janolewandowski/Smart-home/Hardware/CLU.png

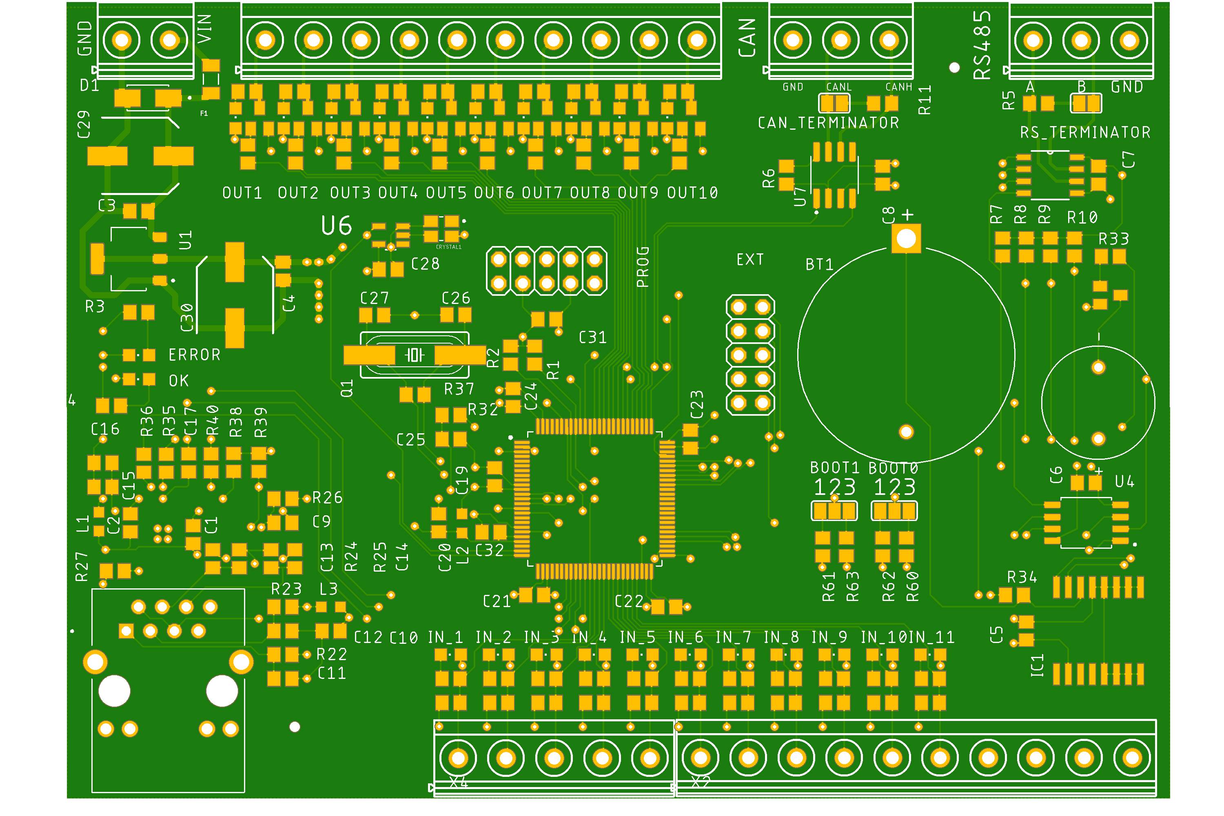
Hardware/CLU.png
