janolewandowski/Smart-home/Hardware/CLU.brd

## EAGLE design Hardware/CLU.brd (2024-02-14)

Schematic: CLU.sch

Parts:
BOOT0, BOOT1: SJ2W; SJ_2
BT1: VL-2320/HFN; BAT_VL-2320/HFN
C1, C2, C3, C4, C5, C6, C7, C8, C9, C11, C12, C13, C14, C17, C18, C19, C20, C21, C22, C23, C24, C25, C28, C31, C32: 100nF; C0805
C10: 0.022uF; C0805
C15: 470pF; C0805
C16: 1uF; C0805
C26, C27: 22pF; C0805
C29, C30: 100uF; SANYO-OSCON_SMD_E7
CAN_TERMINATOR: SJ
CRYSTAL1: LFSPXO025560; LFSPXO025560-SMD-4
D1: BYG10D; DIO_ES1J
ERROR: LEDCHIPLED_0805; CHIPLED_0805
EXT: PINHD-2X5; 2X05
F1: ERBRG1R25V; FUSC1206X75N
IC1: DS3231/SO; SO16W
IN_1, IN_2, IN_3, IN_4, IN_5, IN_6, IN_7, IN_8, IN_9, IN_10, IN_11: LEDCHIPLED_0805; CHIPLED_0805
J2: SI-60062-F; BEL_SI-60062-F
L1, L2, L3: L-USL2012C; L2012C
LS1: CEM-1205C; CUI_CEM-1205C
OK: LEDCHIPLED_0805; CHIPLED_0805
OUT1, OUT2, OUT3, OUT4, OUT5, OUT6, OUT7, OUT8, OUT9, OUT10: LEDCHIPLED_0805; CHIPLED_0805
PROG: PINHD-2X5; 2X05
Q1: CRYSTALHC49UP; HC49UP
R1, R2, R7, R8, R9, R10, R12, R13, R14, R15, R16, R17, R18, R19, R20, R21, R30, R31, R32, R33, R41, R42, R43, R44, R45, R46, R47, R48, R49, R60, R61, R62, R63: 10k; R0805
R3, R4: 330R; R0805
R5, R11: 120R; R0805
R6, R26: 4k7; R0805
R22, R23, R24, R25: 49R9; R0805
R27: 12.1k; R0805
R28, R29, R34, R50, R51, R52, R53, R54, R55, R56, R57, R58, R59, R64, R65, R66, R67, R68, R69, R70, R71, R72, R73, R74: 200R; R0805
R35, R36, R40, R75: 100R; R0805
R37: 1M; R0805
R38, R39: 1k5; R0805
RS_TERMINATOR: SJ
T1, T2, T3, T4, T5, T6, T7, T8, T9, T10, T11: BC848; SOT23
U1: AMS1117; SOT229P700X180-4N
U2: ST3485ECDR; SOIC127P600X175-8N
U3: STM32F107VCT6; QFP50P1600X1600X160-100N
U4: W25Q64BVSSIG; SOIC127P790X216-8N
U5: LAN8720A-CP; QFN50P400X400X100-25N
U6: 74LVC1G17W5-7; SOT95P280X145-5N
U7: SN65HVD230; SOIC127P599X175-8N
X1, X2: MKDSN1,5/10-5,08
X3: MKDSN1,5/2-5,08
X4: MKDSN1,5/5-5,08
X5, X6: MKDSN1,5/3-5,08

Connections:
12V: C3.1, C29.+, D1.K (CATHODE), F1.2, U1.3 (VIN)
BOOT0: BOOT0.2, U3.94 (BOOT0)
BUZZER: R33.1, U3.36 (PB1)
CAN_RX: U3.81 (PD0), U7.4 (R)
CAN_TX: U3.82 (PD1), U7.1 (D)
EHT_MDIO_LAN: R38.1, R75.2, U5.12 (MDIO)
ETH_CRS_DV: R40.1, U3.32 (PA7)
ETH_INT: R39.1, U3.15 (PC0), U5.14 (!NINT!/REFCLKO)
ETH_LED1: R28.1, U5.3 (LED1/REGOFF)
ETH_LED2: R29.1, U5.2 (LED2/!NINTSEL!)
ETH_MDC: U3.16 (PC1), U5.13 (MDC)
ETH_MDIO: R75.1, U3.25 (PA2)
ETH_RBIAS: R27.2, U5.24 (RBIAS)
ETH_RST: C9.1, R26.2, U5.15 (!NRST)
ETH_RXD0: R35.1, U3.33 (PC4)
ETH_RXD1: R36.1, U3.34 (PC5)
ETH_RX_N: C14.1, J2.6 (RD-), R25.2, U5.22 (RXN)
ETH_RX_P: C13.1, J2.4 (RD+), R24.2, U5.23 (RXP)
ETH_TXD0: U3.51 (PB12), U5.17 (TXD0)
ETH_TXD1: U3.52 (PB13), U5.18 (TXD1)
ETH_TX_EN: U3.48 (PB11), U5.16 (TXEN)
ETH_TX_N: C12.1, J2.3 (TD-), R23.2, U5.20 (TXN)
ETH_TX_P: C11.1, J2.1 (TD+), R22.2, U5.21 (TXP)
ETH_VDDA: C1.1, C2.1, J2.9 (YA), L1.2, L3.2, R22.1, R23.1, R24.1, R25.1, U5.1 (VDD2A), U5.19 (VDD1A)
ETH_VDDCR: C15.1, C16.1, U5.6 (VDDCR)
ETH_XTAL1: U3.24 (PA1), U5.5 (XTAL1/CLKLN), U6.4 (Y)
GND: BT1.N, C1.2, C2.2, C3.2, C4.2, C5.2, C6.2, C7.2, C8.2, C9.2, C10.2, C11.2, C12.2, C13.2, C14.2, C15.2, C16.2, C17.2, C18.2, C19.2, C20.2, C21.2, C22.2, C23.2, C24.2, C25.2, C26.1, C27.1, C28.2, C29.-, C30.-, C31.1, C32.2, CRYSTAL1.2 (GND), D1.A (ANODE), ERROR.C, EXT.7, IC1.5 (NC), IC1.6 (NC1), IC1.7 (NC2), IC1.8 (NC3), IC1.9 (NC4), IC1.10 (NC5), IC1.11 (NC6), IC1.12 (NC7), IC1.13 (GND), J2.8, J2.12 (GK), J2.S1 (SHIELD), J2.S2 (SHIELD), OK.C, PROG.4, R6.2, R27.1, R60.1, R61.1, T1.2 (E), T2.2 (E), T3.2 (E), T4.2 (E), T5.2 (E), T6.2 (E), T7.2 (E), T8.2 (E), T9.2 (E), T10.2 (E), T11.2 (E), U1.1 (ADJ/GND), U2.5 (GND), U3.10 (VSS), U3.19 (VSSA), U3.27 (VSS), U3.49 (VSS), U3.74 (VSS), U3.99 (VSS), U4.4 (GND), U5.25 (VSS), U6.3 (GND), U7.2 (GND), X2.7, X2.8, X3.1, X5.1, X6.3
I2C1_SCL: IC1.16 (SCL), R1.2, U3.92 (PB6), X2.10
I2C1_SDA: IC1.15 (SDA), R2.2, U3.93 (PB7), X2.9
IN_1: BOOT1.2, R44.2, R64.2, U3.37 (PB2), X4.1
IN_2: R30.2, R65.2, U3.38 (PE7), X4.2
IN_3: R31.2, R66.2, U3.39 (PE8), X4.3
IN_4: R43.2, R67.2, U3.40 (PE9), X4.4
IN_5: R41.2, R68.2, U3.41 (PE10), X4.5
IN_6: R45.2, R69.2, U3.42 (PE11), X2.1
IN_7: R42.2, R70.2, U3.43 (PE12), X2.2
IN_8: R46.2, R71.2, U3.44 (PE13), X2.3
IN_9: R48.2, R72.2, U3.45 (PE14), X2.4
IN_10: R47.2, R73.2, U3.46 (PE15), X2.5
IN_11: R49.2, R74.2, U3.47 (PB10), X2.6
LED_ERROR: R3.1, U3.3 (PE4)
LED_OK: R4.1, U3.2 (PE3)
unnamed: CAN_TERMINATOR.1, U7.7 (CANH), X5.2
unnamed: R11.2, U7.6 (CANL), X5.3
unnamed: R5.1, U2.6 (A), X6.1
unnamed: RS_TERMINATOR.2, U2.7 (B), X6.2
unnamed: BT1.P, IC1.14 (VBAT), R34.2
unnamed: R17.2, T6.1 (B)
unnamed: R18.2, T7.1 (B)
unnamed: R19.2, T8.1 (B)
unnamed: R20.2, T9.1 (B)
unnamed: OUT1.C, R50.1
unnamed: R21.2, T10.1 (B)
unnamed: R5.2, RS_TERMINATOR.1
unnamed: R6.1, U7.8 (RS)
unnamed: CAN_TERMINATOR.2, R11.1
unnamed: R12.2, T1.1 (B)
unnamed: R13.2, T2.1 (B)
unnamed: OK.A, R4.2
unnamed: ERROR.A, R3.2
unnamed: R14.2, T3.1 (B)
unnamed: R15.2, T4.1 (B)
unnamed: R16.2, T5.1 (B)
unnamed: OUT2.C, R51.1
unnamed: OUT3.C, R52.1
unnamed: OUT4.C, R53.1
unnamed: OUT5.C, R54.1
unnamed: C10.1, J2.2 (TCT), J2.5 (RCT), L3.1
unnamed: OUT6.C, R55.1
unnamed: OUT7.C, R56.1
unnamed: J2.11 (GA), R28.2
unnamed: J2.10 (YK), R29.2
unnamed: R36.2, U5.7 (RXD1/MODE1)
unnamed: R35.2, U5.8 (RXD0/MODE0)
unnamed: LS1.N, T11.3 (C)
unnamed: R33.2, T11.1 (B)
unnamed: OUT8.C, R57.1
unnamed: R40.2, U5.11 (CRS_DV/MODE2)
unnamed: OUT9.C, R58.1
unnamed: OUT10.C, R59.1
unnamed: IN_10.C, R73.1
unnamed: IN_1.C, R64.1
unnamed: BOOT1.1, R61.2
unnamed: BOOT0.1, R60.2
unnamed: BOOT0.3, R62.1
unnamed: BOOT1.3, R63.1
unnamed: IN_2.C, R65.1
unnamed: IN_3.C, R66.1
unnamed: IN_4.C, R67.1
unnamed: IN_5.C, R68.1
unnamed: IN_6.C, R69.1
unnamed: IN_7.C, R70.1
unnamed: IN_8.C, R71.1
unnamed: IN_9.C, R72.1
unnamed: IN_11.C, R74.1
OSC_IN: C26.2, Q1.2, R37.2, U3.12 (OSC_IN)
OSC_OUT: C27.2, Q1.1, R37.1, U3.13 (OSC_OUT)
POWER_IN: F1.1, X3.2
R1_S: R12.1, U3.88 (PD7)
R2_S: R13.1, U3.87 (PD6)
R3_S: R14.1, U3.86 (PD5)
R4_S: R15.1, U3.85 (PD4)
R5_S: R16.1, U3.84 (PD3)
R6_S: R17.1, U3.83 (PD2)
R7_S: R18.1, U3.80 (PC12)
R8_S: R19.1, U3.79 (PC11)
R9_S: R20.1, U3.78 (PC10)
R10_S: R21.1, U3.77 (PA15)
RST: C25.1, R32.1, U3.14 (NRST)
RTC_CHARGE: R34.1, U3.35 (PB0)
SPI1_EXCS: EXT.1, U3.95 (PB8)
SPI1_MISO: EXT.6, U3.90 (PB4), U4.2 (DO(IO1))
SPI1_MOSI: EXT.8, U3.91 (PB5), U4.5 (DI(IO0))
SPI1_SCK: EXT.10, U3.89 (PB3), U4.6 (CLK)
SWCLK: PROG.6, U3.76 (PA14)
SWDIO: PROG.2, U3.72 (PA13)
USART1_DE: R8.1, U2.3 (DE), U3.66 (PC9)
USART1_RE: R9.1, U2.2 (~RE), U3.67 (PA8)
USART1_RX: R10.1, U2.1 (RO), U3.69 (PA10)
USART1_TX: R7.1, U2.4 (DI), U3.68 (PA9)
USB_DM: EXT.2, U3.70 (PA11)
USB_DP: EXT.4, U3.71 (PA12)
VBAT: U3.6 (VBAT)
VCC: C4.1, C5.1, C6.1, C7.1, C8.1, C17.1, C18.1, C19.1, C20.1, C21.1, C22.1, C23.1, C24.1, C28.1, C30.+, C31.2, C32.1, CRYSTAL1.4 (VCC), EXT.3, IC1.2 (VCC), IN_1.A, IN_2.A, IN_3.A, IN_4.A, IN_5.A, IN_6.A, IN_7.A, IN_8.A, IN_9.A, IN_10.A, IN_11.A, L1.1, L2.1, L2.2, LS1.P, OUT1.A, OUT2.A, OUT3.A, OUT4.A, OUT5.A, OUT6.A, OUT7.A, OUT8.A, OUT9.A, OUT10.A, PROG.8, R1.1, R2.1, R7.2, R8.2, R9.2, R10.2, R26.1, R30.1, R31.1, R32.2, R38.2, R39.2, R41.1, R42.1, R43.1, R44.1, R45.1, R46.1, R47.1, R48.1, R49.1, R62.2, R63.2, U1.2 (VOUT), U1.4 (VOUT), U2.8 (VCC), U3.11 (VDD), U3.21 (VREF+), U3.22 (VDDA), U3.28 (VDD), U3.50 (VDD), U3.75 (VDD), U3.100 (VDD), U4.8 (VCC), U5.9 (VDDIO), U6.5 (VCC), U7.3 (VCC)
VREF-: U3.20 (VREF-)
W25Q64_CS: U3.54 (PB15), U4.1 (!CS)
W25Q64_HOLD: U3.56 (PD9), U4.7 (!HOLD!(IO3))
W25Q64_WP: U3.55 (PD8), U4.3 (!WP!(IO2))
X1: R50.2, T1.3 (C), X1.1
X2: R51.2, T2.3 (C), X1.2
X3: R52.2, T3.3 (C), X1.3
X4: R53.2, T4.3 (C), X1.4
X5: R54.2, T5.3 (C), X1.5
X6: R55.2, T6.3 (C), X1.6
X7: R56.2, T7.3 (C), X1.7
X8: R57.2, T8.3 (C), X1.8
X9: R58.2, T9.3 (C), X1.9
X10: R59.2, T10.3 (C), X1.10
X50_OUT: CRYSTAL1.3 (OUT), U6.2 (A)

Notes on the sheet:
RTC DS3231
LEDs
FLASH W25Q64
CAN MCP2551
RS485 ST3485
POWER
OUTPUT CONNECTOR
EXPANDER CONNECTOR
INPUT CONNECTOR
ETH LAN8720
ETH CONNECTOR
PULL - UP/DOWN
PROGRAMMING CONNECTOR
ETH_VDDIO

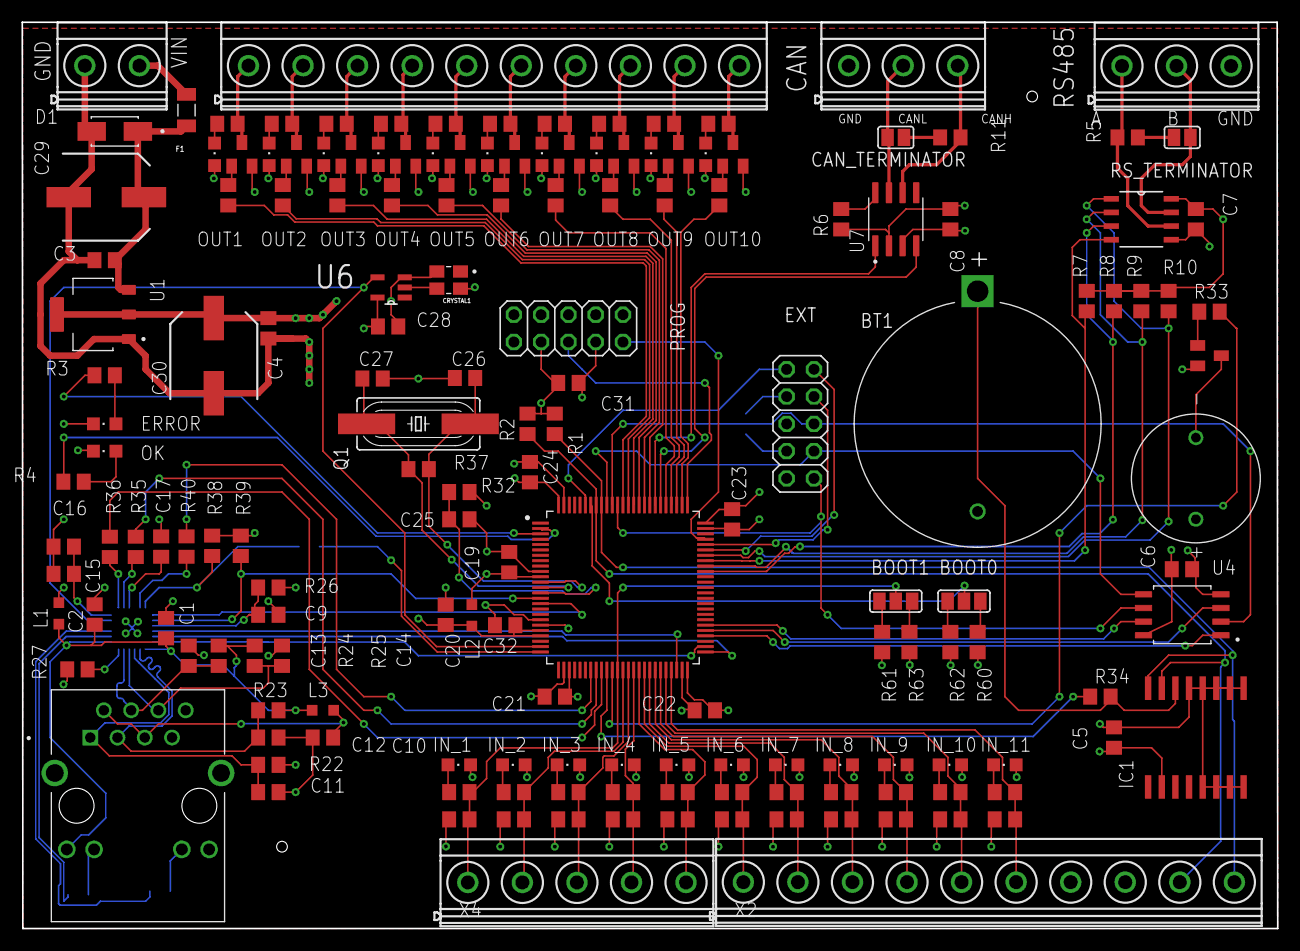
[picture p2: board CLU.brd from above]

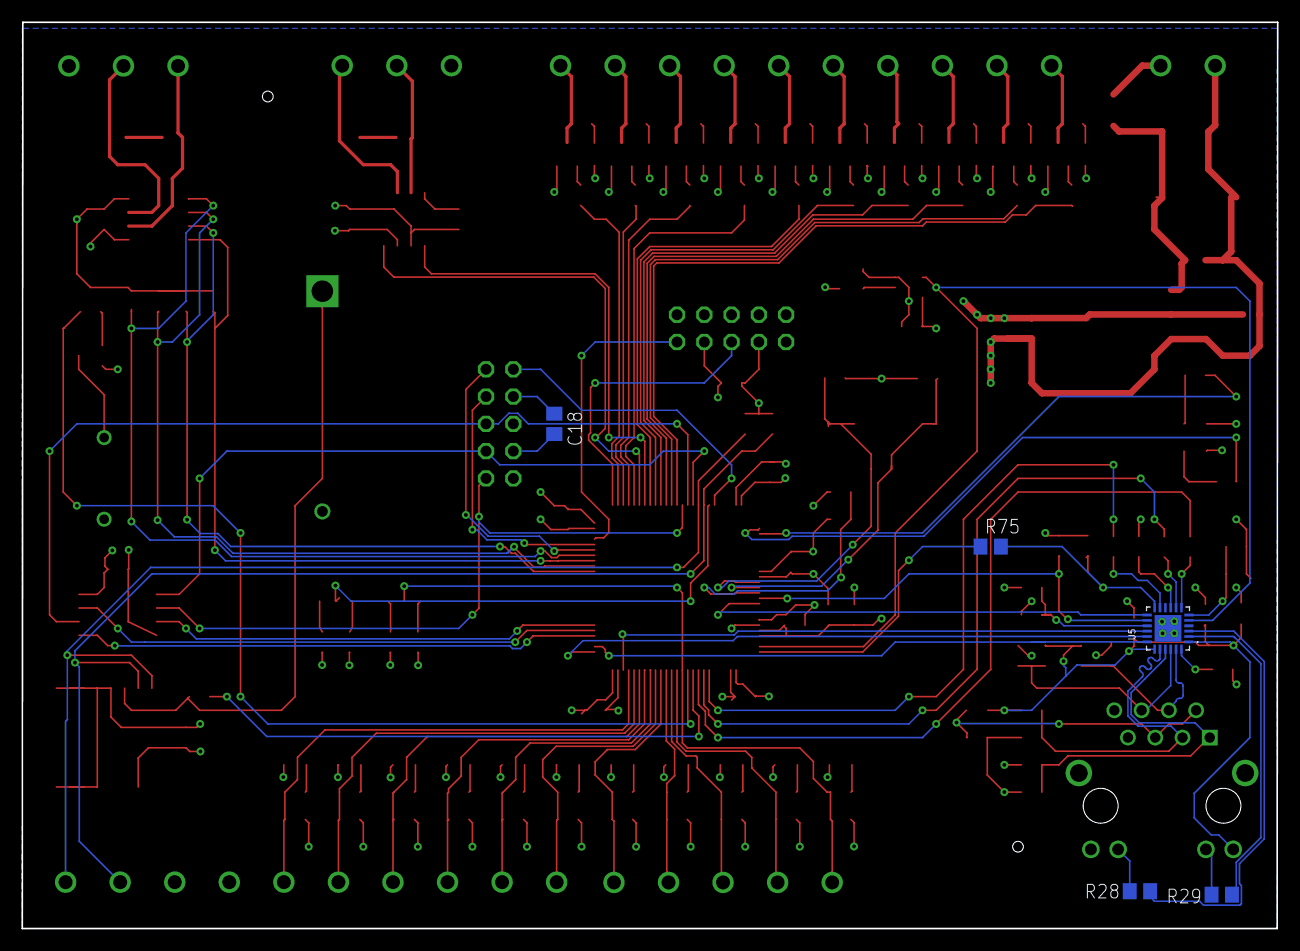
[picture p3: board CLU.brd from below]

Board: 4 copper layers, 116.9 x 84.4 mm, 171 parts (5 on the bottom side), 137 nets.
