janolewandowski/Smart-home/Firmware/Smarthome.ioc

Mcu.UserName=STM32F107VCTx
PA1.Signal=ETH_REF_CLK
PA10.Signal=USART1_RX
PA13.Signal=SYS_JTMS-SWDIO
PA14.Signal=SYS_JTCK-SWCLK
PA15.GPIO_Label=OUT_10
PA15.Signal=GPIO_Output
PA2.Signal=ETH_MDIO
PA7.Signal=ETH_CRS_DV
PA8.GPIO_Label=USART1_RE
PA8.Signal=GPIO_Output
PA9.Signal=USART1_TX
PB0.GPIO_Label=RTC_CHARGE
PB0.Signal=GPIO_Output
PB1.GPIO_Label=BUZZER
PB1.Signal=GPIO_Output
PB10.GPIO_Label=IN_11
PB10.Signal=GPIO_Input
PB11.Signal=ETH_TX_EN
PB12.Signal=ETH_TXD0
PB13.Signal=ETH_TXD1
PB15.GPIO_Label=W25Q64_CS
PB15.Signal=GPIO_Output
PB2.GPIO_Label=IN_1
PB2.Signal=GPIO_Input
PB3.Signal=SPI1_SCK
PB4.Signal=SPI1_MISO
PB5.Signal=SPI1_MOSI
PB6.Signal=I2C1_SCL
PB7.Signal=I2C1_SDA
PC0.GPIO_Label=ETH_INT
PC0.Signal=GPIO_Input
PC1.Signal=ETH_MDC
PC10.GPIO_Label=OUT_9
PC10.Signal=GPIO_Output
PC11.GPIO_Label=OUT_8
PC11.Signal=GPIO_Output
PC12.GPIO_Label=OUT_7
PC12.Signal=GPIO_Output
PC4.Signal=ETH_RXD0
PC5.Signal=ETH_RXD1
PC9.GPIO_Label=USART1_DE
PC9.Signal=GPIO_Output
PD0.Signal=CAN1_RX
PD1.Signal=CAN1_TX
PD2.GPIO_Label=OUT_6
PD2.Signal=GPIO_Output
PD3.GPIO_Label=OUT_5
PD3.Signal=GPIO_Output
PD4.GPIO_Label=OUT_4
PD4.Signal=GPIO_Output
PD5.GPIO_Label=OUT_3
PD5.Signal=GPIO_Output
PD6.GPIO_Label=OUT_2
PD6.Signal=GPIO_Output
PD7.GPIO_Label=OUT_1
PD7.Signal=GPIO_Output
PD8.GPIO_Label=W25Q64_WP
PD8.Signal=GPIO_Output
PD9.GPIO_Label=W25Q64_HOLD
PD9.Signal=GPIO_Output
PE10.GPIO_Label=IN_5
PE10.Signal=GPIO_Input
PE11.GPIO_Label=IN_6
PE11.Signal=GPIO_Input
PE12.GPIO_Label=IN_7
PE12.Signal=GPIO_Input
PE13.GPIO_Label=IN_8
PE13.Signal=GPIO_Input
PE14.GPIO_Label=IN_9
PE14.Signal=GPIO_Input
PE15.GPIO_Label=IN_10
PE15.Signal=GPIO_Input
PE3.GPIO_Label=LED_ERROR
PE3.Signal=GPIO_Output
PE4.GPIO_Label=LED_OK
PE4.Signal=GPIO_Output
PE7.GPIO_Label=IN_2
PE7.Signal=GPIO_Input
PE8.GPIO_Label=IN_3
PE8.Signal=GPIO_Input
PE9.GPIO_Label=IN_4
PE9.Signal=GPIO_Input
